MarcoLaufferOst/CAS_Sensorik_Projekt/docs/xschem_ngspice.md

# ngspice and xschem Cheatsheet

This cheatsheet provides quick access to essential commands and workflows for ngspice and xschem.

## ngspice Simulation Commands

ngspice is a open-source SPICE simulator. Below are frequently used terminal commands for running and analyzing simulations.

| Command | Description |
| --- | --- |
| `setplot` | Displays all simulation runs. |
| `setplot xx` | Sets the active plot to `xx`. |
| `display` | Lists all signals available in the current plot. |
| `plot v(xx) v(xx)` | Plots signals using the default x-axis scale. |
| `setscale xx` | Sets the x-axis scale to signal `xx`. |
| `plot xx vs xxx` | Plots signal `xx` against `xxx`. |

- Use `run` to start a simulation.
- `quit` exits ngspice.
- `show all` displays all simulation parameters.
- `write` saves simulation data to a file.

For a guide to ngspice commands, refer to the [ngspice Control Language Tutorial](https://ngspice.sourceforge.io/ngspice-control-language-tutorial.html).

From the Tutorial:

**plots, variables and vectors**

The output data of any simulation is available as vectors. An operating point simulation will create vectors of length 1, dc simulation will create vectors with length determined by the number of points during sweeping. These vectors are stored in plots, a traditional SPICE notion (see also chapter 13.3 of the manual). 'Plot' here is not to be confused with a plot resulting from plotting data. So a plot is a group of vectors. In our example the first dc command will generate several vectors within a plot dc1. A subsequent dc command will store their vectors in plot dc2 and so on. Transient simulation vectors would have been stored in plots tran1, tran2, etc. So each simulation command (dc, op, tran, sp ...) creates a new plot. The lastly created plot will stay active, until another plot is created or selected. There are also some functions creating their own plots, e.g. fft or linearize. The command setplot will show all plots and mark the active plot. For our example we have this

```plaintext
List of plots available:

Current dc5	inverter example circuit for control language tutorial (DC transfer characteristic)
	dc4	inverter example circuit for control language tutorial (DC transfer characteristic)
	dc3	inverter example circuit for control language tutorial (DC transfer characteristic)
	dc2	inverter example circuit for control language tutorial (DC transfer characteristic)
	dc1	inverter example circuit for control language tutorial (DC transfer characteristic)
	const	Constant values (constants)
```

## xschem Schematic Tool Commands

xschem is a graphical tool for schematic capture. Below are useful commands for manipulating schematics and symbols.

| Command | Description |
| --- | --- |
| `Alt` + `r` | Rotate selected component. |
| `i` / `Ctrl` + `i` | Enter or exit a symbol to edit its sub-schematic. |
| `e` / `Ctrl` + `e` | Dive into or exit the schematic view of a component. |
| `Ctrl` + LMB | Open the schematic or corresponding SPICE file. |
| `t` | Selects a single simulation run. |
| `Shift` + `f` | Flips selected component horizontally. |

### Graph Manipulation (ngspice Plot Window)

| Command | Description |
| --- | --- |
| `f` | Zooms to full view on x-axis (hover over y-axis to scale vertically). |
| `a` or `b` | Places Cursor A or Cursor B. |
| `t` | Selects a specific simulation run. |

### Graph Dialog (Signal Selection)

| Command | Description |
| --- | --- |
| `sig:xx` | Plots signal `xx` and labels it as `sig`. |
| `"name;xx  i(yy) /"` | Names the Signal `name` and `xx` divides by the current `yy` |

## Example Workflow (xschem + ngspice)

- **Create a schematic.**  
- Use the `netlist` button in xschem to generate SPICE netlists, then click `simulation` to launch ngspice.  
  xschem_button  

- **Add a waveform graph** to the schematic by navigating to `Simulation` → `Graphs` → `Add waveform graph`.  

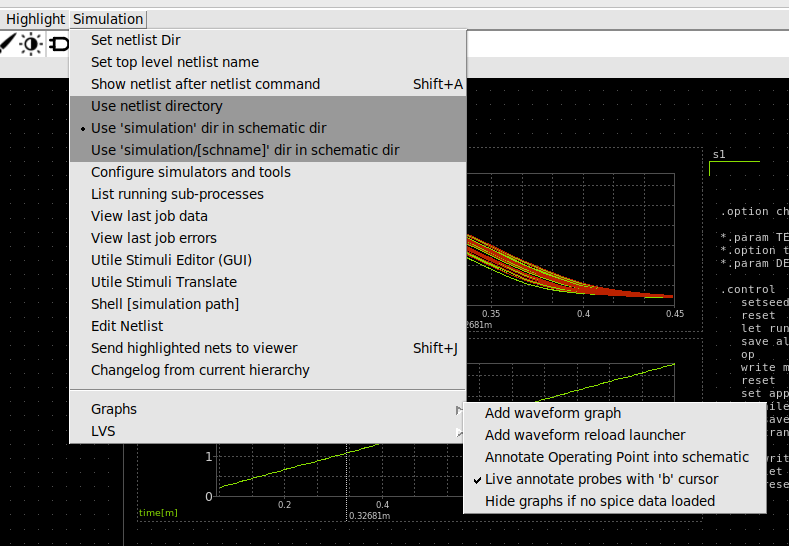
[picture p34: docs/img/xschem_graph.png]
xschem_graph
    

- **Load a .raw file.** One option is to click the `Waves` button in the top right corner. Alternatively, use the `load waves` symbol (`launcher.sym`). Inside this symbol, you can execute TCL commands to load the file:  

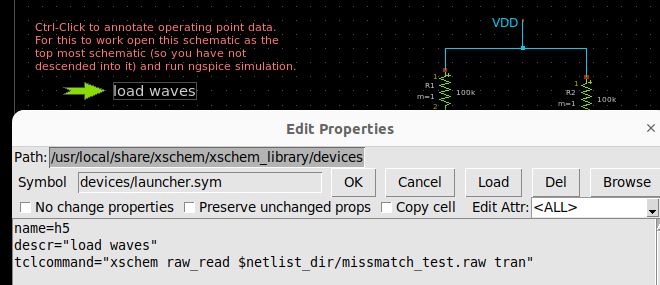
[picture p35: docs/img/xschem_launcher_sym.png]
xschem_load_waves
    

- **Select signals to plot** once the .raw file is loaded. Double-click inside the graph to open the `graphdialog` and choose the signals you want to display:  

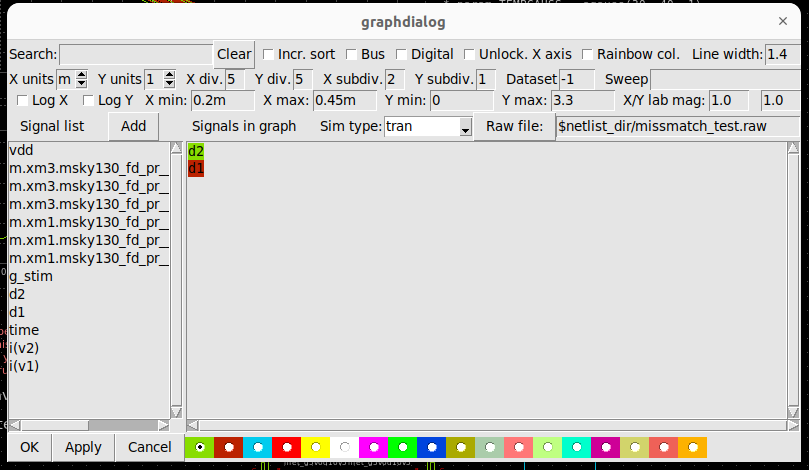
[picture p36: docs/img/xschem_graphdialog.png]
xschem_waves_dia
