MarcoLaufferOst/CAS_Sensorik_Projekt/docs/img/SAR_ADC_drawio.png

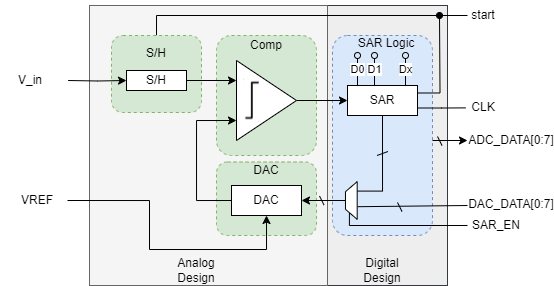
docs/img/SAR_ADC_drawio.png
