MarcoLaufferOst/CAS_Sensorik_Projekt/docs/img/tb_sar_adc.png

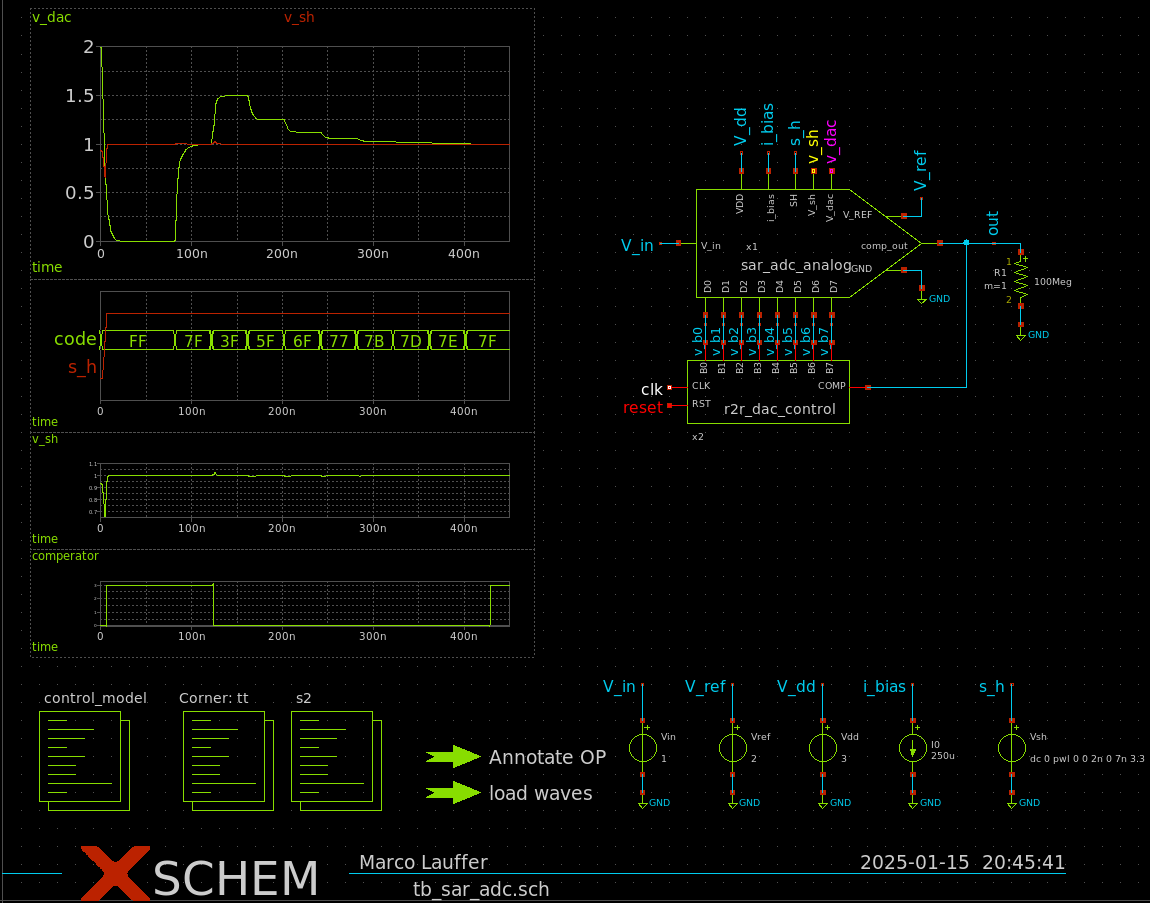
docs/img/tb_sar_adc.png
