MarcoLaufferOst/CAS_Sensorik_Projekt/xschem/png/missmatch_test.png

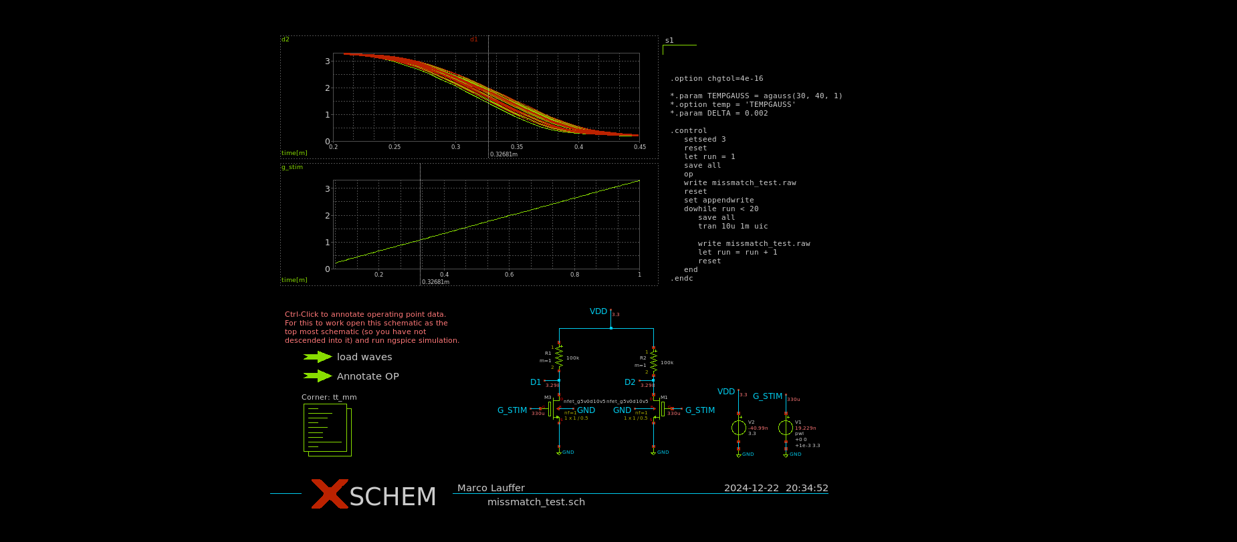
xschem/png/missmatch_test.png
