MarcoLaufferOst/CAS_Sensorik_Projekt/xschem/simulation/stimuli_tb_dac_codes.cir

************************************** 
* SPICE STIMULI FILE 
* generated from 
************************************** 

Vv_b0 v_b0 0 PWL 5n 0 10n 0 11n v_hi 15n v_hi 16n 0 20n 
+0 21n v_hi 25n v_hi 26n 0 30n 0 31n v_hi 35n v_hi 36n 0 
+40n 0 41n v_hi 45n v_hi 46n 0 50n 0 51n v_hi 55n v_hi 56n 
+0 60n 0 61n v_hi 65n v_hi 66n 0 70n 0 71n v_hi 75n v_hi 
+76n 0 80n 0 81n v_hi 85n v_hi 86n 0 90n 0 91n v_hi 95n 
+v_hi 96n 0 100n 0 101n v_hi 105n v_hi 106n 0 110n 0 111n v_hi 
+115n v_hi 116n 0 120n 0 121n v_hi 125n v_hi 126n 0 130n 0 131n 
+v_hi 135n v_hi 136n 0 140n 0 141n v_hi 145n v_hi 146n 0 150n 0 
+151n v_hi 155n v_hi 156n 0 160n 0 161n v_hi 165n v_hi 166n 0 170n 
+0 171n v_hi 175n v_hi 176n 0 180n 0 181n v_hi 185n v_hi 186n 0 
+190n 0 191n v_hi 195n v_hi 196n 0 200n 0 201n v_hi 205n v_hi 206n 
+0 210n 0 211n v_hi 215n v_hi 216n 0 220n 0 221n v_hi 225n v_hi 
+226n 0 230n 0 231n v_hi 235n v_hi 236n 0 240n 0 241n v_hi 245n 
+v_hi 246n 0 250n 0 251n v_hi 255n v_hi 256n 0 260n 0 261n v_hi 
+265n v_hi 266n 0 270n 0 271n v_hi 275n v_hi 276n 0 280n 0 281n 
+v_hi 285n v_hi 286n 0 290n 0 291n v_hi 295n v_hi 296n 0 300n 0 
+301n v_hi 305n v_hi 306n 0 310n 0 311n v_hi 315n v_hi 316n 0 320n 
+0 321n v_hi 325n v_hi 326n 0 330n 0 331n v_hi 335n v_hi 336n 0 
+340n 0 341n v_hi 345n v_hi 346n 0 350n 0 351n v_hi 355n v_hi 356n 
+0 360n 0 361n v_hi 365n v_hi 366n 0 370n 0 371n v_hi 375n v_hi 
+376n 0 380n 0 381n v_hi 385n v_hi 386n 0 390n 0 391n v_hi 395n 
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
+1166n v_hi 1205n v_hi 1206n 0 1245n 0 1246n v_hi 
Vv_b4 v_b4 0 PWL 5n 0 85n 0 86n v_hi 165n v_hi 166n 0 245n 
+0 246n v_hi 325n v_hi 326n 0 405n 0 406n v_hi 485n v_hi 486n 0 
+565n 0 566n v_hi 645n v_hi 646n 0 725n 0 726n v_hi 805n v_hi 806n 
+0 885n 0 886n v_hi 965n v_hi 966n 0 1045n 0 1046n v_hi 1125n v_hi 
+1126n 0 1205n 0 1206n v_hi 
Vv_b5 v_b5 0 PWL 5n 0 165n 0 166n v_hi 325n v_hi 326n 0 485n 
+0 486n v_hi 645n v_hi 646n 0 805n 0 806n v_hi 965n v_hi 966n 0 
+1125n 0 1126n v_hi 
Vv_b6 v_b6 0 PWL 5n 0 325n 0 326n v_hi 645n v_hi 646n 0 965n 
+0 966n v_hi 
Vv_b7 v_b7 0 PWL 5n 0 645n 0 646n v_hi 
