MarcoLaufferOst/CAS_Sensorik_Projekt/xschem/extracted/r2r_dac_parax.spice

* NGSPICE file created from r2r_dac_parax.ext - technology: sky130A

.subckt r2r_dac_parax V_out D1 D2 D5 D7 D4 V_REF D6 D3 D0 V_COM
X0 V_REF.t43 D1.t0 R2R_20k_0.B1.t1 V_REF.t42 sky130_fd_pr__pfet_g5v0d10v5 ad=2.32 pd=16.29 as=2.32 ps=16.29 w=16 l=0.5
X1 R2R_20k_0.B1.t6 a_372_n2638# V_COM.t69 sky130_fd_pr__res_xhigh_po_0p69 l=7
X2 R2R_20k_0.B0.t6 D0.t0 V_REF.t15 V_REF.t14 sky130_fd_pr__pfet_g5v0d10v5 ad=2.32 pd=16.29 as=4.64 ps=32.58 w=16 l=0.5
X3 V_REF.t9 D5.t0 R2R_20k_0.B5.t5 V_REF.t8 sky130_fd_pr__pfet_g5v0d10v5 ad=2.32 pd=16.29 as=2.32 ps=16.29 w=16 l=0.5
X4 R2R_20k_0.B1.t0 D1.t1 V_COM.t64 V_COM.t63 sky130_fd_pr__nfet_g5v0d10v5 ad=1.015 pd=7.29 as=2.03 ps=14.58 w=7 l=0.5
X5 R2R_20k_0.B7.t3 D7.t0 V_COM.t40 V_COM.t39 sky130_fd_pr__nfet_g5v0d10v5 ad=2.03 pd=14.58 as=1.015 ps=7.29 w=7 l=0.5
X6 R2R_20k_0.B6.t5 a_3882_n2638# V_COM.t38 sky130_fd_pr__res_xhigh_po_0p69 l=7
X7 R2R_20k_0.B4.t6 D4.t0 V_REF.t11 V_REF.t10 sky130_fd_pr__pfet_g5v0d10v5 ad=4.64 pd=32.58 as=2.32 ps=16.29 w=16 l=0.5
X8 V_REF.t37 D4.t1 R2R_20k_0.B4.t5 V_REF.t36 sky130_fd_pr__pfet_g5v0d10v5 ad=2.32 pd=16.29 as=2.32 ps=16.29 w=16 l=0.5
X9 a_1542_n838# a_1776_n2638# V_COM.t33 sky130_fd_pr__res_xhigh_po_0p69 l=7
X10 R2R_20k_0.B2.t5 D2.t0 V_REF.t25 V_REF.t24 sky130_fd_pr__pfet_g5v0d10v5 ad=2.32 pd=16.29 as=4.64 ps=32.58 w=16 l=0.5
X11 R2R_20k_0.B2.t2 D2.t1 V_COM.t75 V_COM.t74 sky130_fd_pr__nfet_g5v0d10v5 ad=2.03 pd=14.58 as=1.015 ps=7.29 w=7 l=0.5
X12 a_138_n838# a_n564_n838# V_COM.t47 sky130_fd_pr__res_xhigh_po_0p69 l=7
X13 R2R_20k_0.B6.t4 D6.t0 V_REF.t27 V_REF.t26 sky130_fd_pr__pfet_g5v0d10v5 ad=2.32 pd=16.29 as=4.64 ps=32.58 w=16 l=0.5
X14 R2R_20k_0.B2.t1 D2.t2 V_COM.t20 V_COM.t19 sky130_fd_pr__nfet_g5v0d10v5 ad=1.015 pd=7.29 as=2.03 ps=14.58 w=7 l=0.5
X15 R2R_20k_0.B7.t2 D7.t1 V_COM.t52 V_COM.t51 sky130_fd_pr__nfet_g5v0d10v5 ad=1.015 pd=7.29 as=2.03 ps=14.58 w=7 l=0.5
X16 a_2946_n838# a_3180_n2638# V_COM.t50 sky130_fd_pr__res_xhigh_po_0p69 l=7
X17 R2R_20k_0.B6.t2 D6.t1 V_REF.t17 V_REF.t16 sky130_fd_pr__pfet_g5v0d10v5 ad=4.64 pd=32.58 as=2.32 ps=16.29 w=16 l=0.5
X18 a_1542_n838# a_840_n838# V_COM.t46 sky130_fd_pr__res_xhigh_po_0p69 l=7
X19 R2R_20k_0.B5.t4 D5.t1 V_REF.t21 V_REF.t20 sky130_fd_pr__pfet_g5v0d10v5 ad=4.64 pd=32.58 as=2.32 ps=16.29 w=16 l=0.5
X20 V_REF.t47 D7.t2 R2R_20k_0.B7.t6 V_REF.t46 sky130_fd_pr__pfet_g5v0d10v5 ad=2.32 pd=16.29 as=2.32 ps=16.29 w=16 l=0.5
X21 a_3648_n838# a_2946_n838# V_COM.t66 sky130_fd_pr__res_xhigh_po_0p69 l=7
X22 R2R_20k_0.B0.t5 D0.t1 V_REF.t23 V_REF.t22 sky130_fd_pr__pfet_g5v0d10v5 ad=4.64 pd=32.58 as=2.32 ps=16.29 w=16 l=0.5
X23 R2R_20k_0.B3.t3 D3.t0 V_COM.t24 V_COM.t23 sky130_fd_pr__nfet_g5v0d10v5 ad=2.03 pd=14.58 as=1.015 ps=7.29 w=7 l=0.5
X24 a_840_n838# a_1074_n2638# V_COM.t73 sky130_fd_pr__res_xhigh_po_0p69 l=7
X25 V_COM.t71 V_COM.t72 V_COM.t70 sky130_fd_pr__res_xhigh_po_0p69 l=7
X26 R2R_20k_0.B3.t6 D3.t1 V_REF.t3 V_REF.t2 sky130_fd_pr__pfet_g5v0d10v5 ad=4.64 pd=32.58 as=2.32 ps=16.29 w=16 l=0.5
X27 V_REF.t33 D6.t2 R2R_20k_0.B6.t6 V_REF.t32 sky130_fd_pr__pfet_g5v0d10v5 ad=2.32 pd=16.29 as=2.32 ps=16.29 w=16 l=0.5
X28 V_COM.t77 V_COM.t78 V_COM.t76 sky130_fd_pr__res_xhigh_po_0p69 l=7
X29 V_COM.t68 a_n798_n2638# V_COM.t67 sky130_fd_pr__res_xhigh_po_0p69 l=7
X30 R2R_20k_0.B5.t6 a_3180_n2638# V_COM.t79 sky130_fd_pr__res_xhigh_po_0p69 l=7
X31 R2R_20k_0.B1.t2 D1.t2 V_REF.t41 V_REF.t40 sky130_fd_pr__pfet_g5v0d10v5 ad=2.32 pd=16.29 as=4.64 ps=32.58 w=16 l=0.5
X32 R2R_20k_0.B3.t2 D3.t2 V_COM.t7 V_COM.t6 sky130_fd_pr__nfet_g5v0d10v5 ad=1.015 pd=7.29 as=2.03 ps=14.58 w=7 l=0.5
X33 R2R_20k_0.B4.t3 D4.t2 V_COM.t18 V_COM.t17 sky130_fd_pr__nfet_g5v0d10v5 ad=1.015 pd=7.29 as=2.03 ps=14.58 w=7 l=0.5
X34 R2R_20k_0.B1.t3 D1.t3 V_REF.t39 V_REF.t38 sky130_fd_pr__pfet_g5v0d10v5 ad=4.64 pd=32.58 as=2.32 ps=16.29 w=16 l=0.5
X35 R2R_20k_0.B0.t3 D0.t2 V_COM.t12 V_COM.t11 sky130_fd_pr__nfet_g5v0d10v5 ad=1.015 pd=7.29 as=2.03 ps=14.58 w=7 l=0.5
X36 V_COM.t32 D5.t2 R2R_20k_0.B5.t2 V_COM.t31 sky130_fd_pr__nfet_g5v0d10v5 ad=1.015 pd=7.29 as=1.015 ps=7.29 w=7 l=0.5
X37 V_COM.t56 D4.t3 R2R_20k_0.B4.t2 V_COM.t55 sky130_fd_pr__nfet_g5v0d10v5 ad=1.015 pd=7.29 as=1.015 ps=7.29 w=7 l=0.5
X38 R2R_20k_0.B7.t5 D7.t3 V_REF.t29 V_REF.t28 sky130_fd_pr__pfet_g5v0d10v5 ad=4.64 pd=32.58 as=2.32 ps=16.29 w=16 l=0.5
X39 R2R_20k_0.B1.t4 D1.t4 V_COM.t62 V_COM.t61 sky130_fd_pr__nfet_g5v0d10v5 ad=2.03 pd=14.58 as=1.015 ps=7.29 w=7 l=0.5
X40 R2R_20k_0.B6.t3 D6.t3 V_COM.t27 V_COM.t26 sky130_fd_pr__nfet_g5v0d10v5 ad=2.03 pd=14.58 as=1.015 ps=7.29 w=7 l=0.5
X41 a_n564_n838# a_n798_n2638# V_COM.t58 sky130_fd_pr__res_xhigh_po_0p69 l=7
X42 V_REF.t7 D0.t3 R2R_20k_0.B0.t4 V_REF.t6 sky130_fd_pr__pfet_g5v0d10v5 ad=2.32 pd=16.29 as=2.32 ps=16.29 w=16 l=0.5
X43 R2R_20k_0.B5.t3 D5.t3 V_REF.t19 V_REF.t18 sky130_fd_pr__pfet_g5v0d10v5 ad=2.32 pd=16.29 as=4.64 ps=32.58 w=16 l=0.5
X44 V_COM.t29 D3.t3 R2R_20k_0.B3.t1 V_COM.t28 sky130_fd_pr__nfet_g5v0d10v5 ad=1.015 pd=7.29 as=1.015 ps=7.29 w=7 l=0.5
X45 R2R_20k_0.B5.t1 D5.t4 V_COM.t49 V_COM.t48 sky130_fd_pr__nfet_g5v0d10v5 ad=2.03 pd=14.58 as=1.015 ps=7.29 w=7 l=0.5
X46 R2R_20k_0.B2.t6 a_1074_n2638# V_COM.t65 sky130_fd_pr__res_xhigh_po_0p69 l=7
X47 V_out.t1 a_4584_n2638# V_COM.t57 sky130_fd_pr__res_xhigh_po_0p69 l=7
X48 V_REF.t13 D2.t3 R2R_20k_0.B2.t4 V_REF.t12 sky130_fd_pr__pfet_g5v0d10v5 ad=2.32 pd=16.29 as=2.32 ps=16.29 w=16 l=0.5
X49 R2R_20k_0.B0.t2 D0.t4 V_COM.t10 V_COM.t9 sky130_fd_pr__nfet_g5v0d10v5 ad=2.03 pd=14.58 as=1.015 ps=7.29 w=7 l=0.5
X50 R2R_20k_0.B4.t1 D4.t4 V_COM.t16 V_COM.t15 sky130_fd_pr__nfet_g5v0d10v5 ad=2.03 pd=14.58 as=1.015 ps=7.29 w=7 l=0.5
X51 a_840_n838# a_138_n838# V_COM.t43 sky130_fd_pr__res_xhigh_po_0p69 l=7
X52 a_2946_n838# a_2244_n838# V_COM.t41 sky130_fd_pr__res_xhigh_po_0p69 l=7
X53 V_COM.t54 D0.t5 R2R_20k_0.B0.t1 V_COM.t53 sky130_fd_pr__nfet_g5v0d10v5 ad=1.015 pd=7.29 as=1.015 ps=7.29 w=7 l=0.5
X54 R2R_20k_0.B5.t0 D5.t5 V_COM.t45 V_COM.t44 sky130_fd_pr__nfet_g5v0d10v5 ad=1.015 pd=7.29 as=2.03 ps=14.58 w=7 l=0.5
X55 V_out.t0 a_3648_n838# V_COM.t5 sky130_fd_pr__res_xhigh_po_0p69 l=7
X56 V_COM.t60 D1.t5 R2R_20k_0.B1.t5 V_COM.t59 sky130_fd_pr__nfet_g5v0d10v5 ad=1.015 pd=7.29 as=1.015 ps=7.29 w=7 l=0.5
X57 a_2244_n838# a_2478_n2638# V_COM.t37 sky130_fd_pr__res_xhigh_po_0p69 l=7
X58 R2R_20k_0.B4.t0 a_2478_n2638# V_COM.t4 sky130_fd_pr__res_xhigh_po_0p69 l=7
X59 R2R_20k_0.B2.t3 D2.t4 V_REF.t5 V_REF.t4 sky130_fd_pr__pfet_g5v0d10v5 ad=4.64 pd=32.58 as=2.32 ps=16.29 w=16 l=0.5
X60 a_138_n838# a_372_n2638# V_COM.t30 sky130_fd_pr__res_xhigh_po_0p69 l=7
X61 R2R_20k_0.B7.t4 D7.t4 V_REF.t31 V_REF.t30 sky130_fd_pr__pfet_g5v0d10v5 ad=2.32 pd=16.29 as=4.64 ps=32.58 w=16 l=0.5
X62 R2R_20k_0.B7.t0 a_4584_n2638# V_COM.t25 sky130_fd_pr__res_xhigh_po_0p69 l=7
X63 R2R_20k_0.B4.t4 D4.t5 V_REF.t45 V_REF.t44 sky130_fd_pr__pfet_g5v0d10v5 ad=2.32 pd=16.29 as=4.64 ps=32.58 w=16 l=0.5
X64 a_n564_n838# a_n330_n2638# V_COM.t36 sky130_fd_pr__res_xhigh_po_0p69 l=7
X65 a_2244_n838# a_1542_n838# V_COM.t3 sky130_fd_pr__res_xhigh_po_0p69 l=7
X66 V_REF.t1 D3.t4 R2R_20k_0.B3.t5 V_REF.t0 sky130_fd_pr__pfet_g5v0d10v5 ad=2.32 pd=16.29 as=2.32 ps=16.29 w=16 l=0.5
X67 R2R_20k_0.B6.t1 D6.t4 V_COM.t22 V_COM.t21 sky130_fd_pr__nfet_g5v0d10v5 ad=1.015 pd=7.29 as=2.03 ps=14.58 w=7 l=0.5
X68 R2R_20k_0.B3.t4 D3.t5 V_REF.t35 V_REF.t34 sky130_fd_pr__pfet_g5v0d10v5 ad=2.32 pd=16.29 as=4.64 ps=32.58 w=16 l=0.5
X69 R2R_20k_0.B0.t0 a_n330_n2638# V_COM.t2 sky130_fd_pr__res_xhigh_po_0p69 l=7
X70 a_3648_n838# a_3882_n2638# V_COM.t8 sky130_fd_pr__res_xhigh_po_0p69 l=7
X71 V_COM.t14 D2.t5 R2R_20k_0.B2.t0 V_COM.t13 sky130_fd_pr__nfet_g5v0d10v5 ad=1.015 pd=7.29 as=1.015 ps=7.29 w=7 l=0.5
X72 V_COM.t1 D6.t5 R2R_20k_0.B6.t0 V_COM.t0 sky130_fd_pr__nfet_g5v0d10v5 ad=1.015 pd=7.29 as=1.015 ps=7.29 w=7 l=0.5
X73 V_COM.t35 D7.t5 R2R_20k_0.B7.t1 V_COM.t34 sky130_fd_pr__nfet_g5v0d10v5 ad=1.015 pd=7.29 as=1.015 ps=7.29 w=7 l=0.5
X74 R2R_20k_0.B3.t0 a_1776_n2638# V_COM.t42 sky130_fd_pr__res_xhigh_po_0p69 l=7
R0 D1.n5 D1.t3 963.587
R1 D1.n0 D1.t0 963.587
R2 D1.n1 D1.t2 963.587
R3 D1.n2 D1.t1 515.91
R4 D1.n3 D1.t5 515.91
R5 D1.n4 D1.t4 515.91
R6 D1.n4 D1.n3 59.4829
R7 D1.n3 D1.n2 59.4829
R8 D1.n3 D1.n0 9.54099
R9 D1.n5 D1.n4 9.54099
R10 D1.n2 D1.n1 9.54099
R11 D1 D1.n6 7.56993
R12 D1 D1.n0 0.063
R13 D1.n6 D1.n5 0.0604957
R14 D1.n6 D1.n0 0.0402155
R15 D1.n1 D1 0.03675
R16 R2R_20k_0.B1.n5 R2R_20k_0.B1.t6 21.7027
R17 R2R_20k_0.B1.n3 R2R_20k_0.B1.t3 20.8848
R18 R2R_20k_0.B1.n2 R2R_20k_0.B1.n0 19.1576
R19 R2R_20k_0.B1.n3 R2R_20k_0.B1.t4 12.3059
R20 R2R_20k_0.B1.n2 R2R_20k_0.B1.n1 9.94452
R21 R2R_20k_0.B1.n1 R2R_20k_0.B1.t5 2.36193
R22 R2R_20k_0.B1.n1 R2R_20k_0.B1.t0 2.36193
R23 R2R_20k_0.B1.n4 R2R_20k_0.B1.n3 1.83465
R24 R2R_20k_0.B1.n4 R2R_20k_0.B1.n2 1.82789
R25 R2R_20k_0.B1.n0 R2R_20k_0.B1.t1 1.73144
R26 R2R_20k_0.B1.n0 R2R_20k_0.B1.t2 1.73144
R27 R2R_20k_0.B1.n5 R2R_20k_0.B1 0.80378
R28 R2R_20k_0.B1 R2R_20k_0.B1.n4 0.0623812
R29 R2R_20k_0.B1 R2R_20k_0.B1.n5 0.06175
R30 V_REF.n27 V_REF.n21 6832.14
R31 V_REF.n17 V_REF.n16 6832.14
R32 V_REF.n37 V_REF.n15 6832.14
R33 V_REF.n11 V_REF.n10 6832.14
R34 V_REF.n47 V_REF.n9 6832.14
R35 V_REF.n48 V_REF.n5 6832.14
R36 V_REF.n3 V_REF.n2 6710.8
R37 V_REF.n27 V_REF.n26 749.662
R38 V_REF.n28 V_REF.n27 729.207
R39 V_REF.n28 V_REF.n16 729.207
R40 V_REF.n36 V_REF.n16 729.207
R41 V_REF.n37 V_REF.n36 729.207
R42 V_REF.n38 V_REF.n37 729.207
R43 V_REF.n38 V_REF.n10 729.207
R44 V_REF.n46 V_REF.n10 729.207
R45 V_REF.n47 V_REF.n46 729.207
R46 V_REF.n49 V_REF.n47 729.207
R47 V_REF.n49 V_REF.n48 729.207
R48 V_REF.n48 V_REF.n4 729.207
R49 V_REF.n25 V_REF.n21 729.207
R50 V_REF.n29 V_REF.n21 729.207
R51 V_REF.n29 V_REF.n17 729.207
R52 V_REF.n35 V_REF.n17 729.207
R53 V_REF.n35 V_REF.n15 729.207
R54 V_REF.n39 V_REF.n15 729.207
R55 V_REF.n39 V_REF.n11 729.207
R56 V_REF.n45 V_REF.n11 729.207
R57 V_REF.n45 V_REF.n9 729.207
R58 V_REF.n50 V_REF.n9 729.207
R59 V_REF.n50 V_REF.n5 729.207
R60 V_REF.n57 V_REF.n5 729.207
R61 V_REF.n58 V_REF.n3 692.532
R62 V_REF.n57 V_REF.n2 672.077
R63 V_REF.n59 V_REF.n2 668.277
R64 V_REF.n4 V_REF.n3 668.277
R65 V_REF.t30 V_REF.t16 108.674
R66 V_REF.t26 V_REF.t20 108.674
R67 V_REF.t18 V_REF.t10 108.674
R68 V_REF.t44 V_REF.t2 108.674
R69 V_REF.t34 V_REF.t4 108.674
R70 V_REF.t24 V_REF.t38 108.674
R71 V_REF.t22 V_REF.t40 108.15
R72 V_REF.t46 V_REF.t28 40.3066
R73 V_REF.t46 V_REF.t30 40.3066
R74 V_REF.t32 V_REF.t16 40.3066
R75 V_REF.t32 V_REF.t26 40.3066
R76 V_REF.t8 V_REF.t20 40.3066
R77 V_REF.t8 V_REF.t18 40.3066
R78 V_REF.t36 V_REF.t10 40.3066
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
C242 R2R_20k_0.B4.t4 V_COM 0.179836f
C243 R2R_20k_0.B4.n1 V_COM 1.06898f
C244 R2R_20k_0.B4.t2 V_COM 0.078678f
C245 R2R_20k_0.B4.t3 V_COM 0.078678f
C246 R2R_20k_0.B4.n2 V_COM 0.179012f
C247 R2R_20k_0.B4.n3 V_COM 2.38987f
C248 R2R_20k_0.B4.n4 V_COM 0.661136f
C249 R2R_20k_0.B4.t0 V_COM 0.083991f
C250 R2R_20k_0.B4.n5 V_COM 0.799643f
C251 D4.t1 V_COM 0.856478f
C252 D4.n0 V_COM 0.433443f
C253 D4.t0 V_COM 0.856478f
C254 D4.t4 V_COM 0.393581f
C255 D4.t3 V_COM 0.393581f
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
