MarcoLaufferOst/CAS_Sensorik_Projekt/verilog/gl/r2r_dac_control.v

module r2r_dac_control (VGND,
    VPWR,
    clk,
    comp,
    reset,
    data_out);
 input VGND;
 input VPWR;
 input clk;
 input comp;
 input reset;
 output [7:0] data_out;

 wire _000_;
 wire _001_;
 wire _002_;
 wire _003_;
 wire _004_;
 wire _005_;
 wire _006_;
 wire _007_;
 wire _008_;
 wire _009_;
 wire _010_;
 wire _011_;
 wire _012_;
 wire _013_;
 wire _014_;
 wire _015_;
 wire _016_;
 wire _017_;
 wire _018_;
 wire _019_;
 wire _020_;
 wire _021_;
 wire _022_;
 wire _023_;
 wire _024_;
 wire _025_;
 wire _026_;
 wire _027_;
 wire _028_;
 wire _029_;
 wire _030_;
 wire _031_;
 wire _032_;
 wire _033_;
 wire _034_;
 wire _035_;
 wire _036_;
 wire _037_;
 wire _038_;
 wire _039_;
 wire _040_;
 wire _041_;
 wire _042_;
 wire _043_;
 wire _044_;
 wire _045_;
 wire _046_;
 wire \bit_index[0] ;
 wire \bit_index[1] ;
 wire \bit_index[2] ;
 wire clknet_0_clk;
 wire clknet_1_0__leaf_clk;
 wire clknet_1_1__leaf_clk;
 wire net1;
 wire net10;
 wire net11;
 wire net2;
 wire net3;
 wire net4;
 wire net5;
 wire net6;
 wire net7;
 wire net8;
 wire net9;
 wire \out_data[0] ;
 wire \out_data[1] ;
 wire \out_data[2] ;
 wire \out_data[3] ;
 wire \out_data[4] ;
 wire \out_data[5] ;
 wire \out_data[6] ;
 wire \out_data[7] ;
 wire state;

 sky130_fd_sc_hd__decap_8 FILLER_0_0_101 (.VGND(VGND),
    .VNB(VGND),
    .VPB(VPWR),
    .VPWR(VPWR));
 sky130_fd_sc_hd__decap_3 FILLER_0_0_109 (.VGND(VGND),
    .VNB(VGND),
    .VPB(VPWR),
    .VPWR(VPWR));
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
    .X(net4));
 sky130_fd_sc_hd__dlygate4sd3_1 hold2 (.A(\out_data[0] ),
    .VGND(VGND),
    .VNB(VGND),
    .VPB(VPWR),
    .VPWR(VPWR),
    .X(net5));
 sky130_fd_sc_hd__dlygate4sd3_1 hold3 (.A(\out_data[5] ),
    .VGND(VGND),
    .VNB(VGND),
    .VPB(VPWR),
    .VPWR(VPWR),
    .X(net6));
 sky130_fd_sc_hd__dlygate4sd3_1 hold4 (.A(\out_data[7] ),
    .VGND(VGND),
    .VNB(VGND),
    .VPB(VPWR),
    .VPWR(VPWR),
    .X(net7));
 sky130_fd_sc_hd__dlygate4sd3_1 hold5 (.A(\bit_index[2] ),
    .VGND(VGND),
    .VNB(VGND),
    .VPB(VPWR),
    .VPWR(VPWR),
    .X(net8));
 sky130_fd_sc_hd__dlygate4sd3_1 hold6 (.A(_014_),
    .VGND(VGND),
    .VNB(VGND),
    .VPB(VPWR),
    .VPWR(VPWR),
    .X(net9));
 sky130_fd_sc_hd__dlygate4sd3_1 hold7 (.A(\bit_index[1] ),
    .VGND(VGND),
    .VNB(VGND),
    .VPB(VPWR),
    .VPWR(VPWR),
    .X(net10));
 sky130_fd_sc_hd__dlygate4sd3_1 hold8 (.A(\out_data[6] ),
    .VGND(VGND),
    .VNB(VGND),
    .VPB(VPWR),
    .VPWR(VPWR),
    .X(net11));
 sky130_fd_sc_hd__clkbuf_2 input1 (.A(comp),
    .VGND(VGND),
    .VNB(VGND),
    .VPB(VPWR),
    .VPWR(VPWR),
    .X(net1));
 sky130_fd_sc_hd__buf_1 input2 (.A(reset),
    .VGND(VGND),
    .VNB(VGND),
    .VPB(VPWR),
    .VPWR(VPWR),
    .X(net2));
endmodule
