MarcoLaufferOst/CAS_Sensorik_Projekt/(commit log)

2024-12-14 add Makefile and xschemrc
    [inverter.sch]
2024-12-19 comparator schematic
    [comparator1.sch]
2024-12-20 create a converter to convert the paths for the xschemrc file
    [comparator1.sch]
2024-12-22 create a mismatch test simulation
    [missmatch_test.sch]
2024-12-24 add doc for R2R DAC and Missmatch simulation for Resistors
2024-12-25 FET dim done
2024-12-25 create a testbench template an a scipt to build a tb
    [tb_template.sch]
2024-12-25 spec for resistor simulation
    [missmatch_res_spec.sch]
2024-12-25 spec for mosfets for the DAC Switch
    [missmatch_spec_mos_dc.sch, missmatch_spec_pmos_dc.sch]
2024-12-27 create DAC-Switch
    [dac_switch.sch]
2024-12-27 testbenches for DAC-Switch
    [tb_dac_dc_transfer.sch, tb_dac_switch_dc_switching.sch, tb_dac_switch_dc_transfer.sch, tb_dac_switch_trans_sw.sch]
2024-12-27 create R2R ladder
    [R2R_20k.sch]
2024-12-27 create R2R DAC top
    [r2r_dac.sch]
2024-12-28 add tb for DAC performance
    [tb_dac_performance.sch]
2024-12-30 new comparator and test bench
    [comparator.sch, tb_comp_ac.sch, tb_comp_op.sch, tb_comp_tran.sch, tb_comp_tran_vos_tt_mm.sch, tb_comp_vcm_sweep_ac.sch]
2025-01-02 new dac switches 80/0.5 and 35/0.5
    [dac_switch.sch]
2025-01-02 update dac tb v2
    [R2R_20k.sch, tb_dac_dc_transfer.sch, tb_dac_performance.sch]
2025-01-02 DAC Switch fets tb update
    [missmatch_spec_mos_dc.sch, missmatch_spec_pmos_dc.sch]
2025-01-02 create netlists for DAC Switch and R2R for LVS
2025-01-03 convert the comp schematics
    [tb_comp_ac.sch, tb_comp_op.sch, tb_comp_tran.sch, tb_comp_tran_vos_tt_mm.sch, tb_comp_vcm_sweep_ac.sch]
2025-01-05 update w/l in dac switch from 5 tu 3 fingers
    [dac_switch.sch]
2025-01-05 create a layout for the dac switch and pass lvs
2025-01-05 add dummy R to the schematic for lvs
    [R2R_20k.sch]
2025-01-06 update tb for dac
    [tb_dac_performance.sch]
2025-01-06 connect r to switches
2025-01-06 simulate dac with parax model
    [tb_dac_parax_perf.sch]
2025-01-08 comparator schematic updated
    [comparator.sch]
2025-01-08 sample and hold sch,sym,mag files
    [sample_hold.sch]
2025-01-09 multiplexer files: mag,sym,sch
    [mux_4to1.sch]
2025-01-10 tb analog swand mux
    [tb_analog_sw.sch, tb_mux_4to1_tran.sch]
2025-01-13 update sample_hold.sch libraray paths
    [sample_hold.sch]
2025-01-13 add project files for digital sinth
    [pin_order.cfg]
2025-01-15 add sar_adc_analog to the project
    [sar_adc_analog.sch, tb_sar_adc_analog.sch]
2025-01-15 create a cosim in xschem with verilog and spice for dac_control
    [tb_dac_control.sch]
2025-01-15 add a testbench for the sar_adc with cosim
    [tb_sar_adc.sch]
2025-01-15 openlane pin config changes
    [pin_order.cfg]
2025-01-18 iptat files: schematic,symbol,layout
    [iptat.sch]
2025-01-21 create adc spice for lvs
2025-01-21 make adc perf tb
    [tb_sar_adc_perf.sch]
